NielsDeSimpelaere/Linefollower/readme.md

# LineFollower
<br />
Dit is mijn linefollower
<br />

<br />
Linefollower

<br />
<br />
  
## specifications
<br />
microcontroller: arduino nano
<br />
motors: 50: 1 Micro Metal gearmotor HPCB 6V met Extended Motor Shaft 
<br />
h-bridge: DRV8833
<br />
sensors: QTR-8A
<br />
batteries:  2x LG 18650 Li-ion Batterij - 3400mAh - 10A
<br />
wireless communication: HC-05 Bluetooth module met adapter
<br />
distance sensor - motors: 10,3 cm
<br />
weight: 201 g
<br />
speed: 0,45 m/s
<br />
