NielsDeSimpelaere/Linefollower/gebruiksaanwijzing/readme.md

# Gebruiksaanwijzing

### opladen / vervangen batterijen
Zorg er bij het insteken of het uithalen van de batterijen voor dat de blauwe schakelaar, op de batterijhouder gemonteerd,
uit staat (naar het linker wiel van achteren bekeken toe gericht is).

Om de batterijen op te laden, wordt gebruikt gemaakt van de Xtar MC1 Li-ion Mini Batterijlader. Deze kan 1 batterij opladen op hetzelfde moment
opladen. Zorg ervoor dat de batterij wordt opgeladen tot ongeveer een spanning van 3,5V. Om dit te weten, haal de batterij uit de oplader en meet
de spanning op met een multimeter. Wanneer beide batterijen elk op hun beurt opgeladen zijn tot 3,5V, dan kunnen ze weer in de batterijhouder geplaatst
worden. Zorg ervoor dat de gebruikte batterijen  van het type LG 18650 Li-ion Batterij - 3400mAh - 10A - INR18650 MJ1 zijn.

### draadloze communicatie
#### verbinding maken
Verbinden van de linefollower en de smartphone gebeurt via de app Serial Bluetooth Terminal. Leg bluetooth aan op je smartphone, en ga in de app naar devices. Zorg ervoor dat je verbonden bent met de HC-05. Ga daarna naar de terminal en verbind rechtsboven door ophet symbooltje van de 2 connecties te klikken. Daarna krijg je de melding dat de HC-05 verbonden ("connected") is.

#### commando's
debug: wanneer je dit intypt, zie je al de ingestelde waardes
<br /> 
run: bij het intypenvan run bij stilstand van de linefollower, zal dit de linefollower starten.       Om de linefollower te stoppen moet run opnieuw verzonden worden
<br />
set cycle [µs] : hiermee wordt de waarde van de cycle gedefinieerd .
<br />
set power [0..255] : stel in hoeveel van het maximale vermogen wordt gebruikt.
<br />
set diff [0..1] : zorgt voor de mate van bijsturen bij bochten. Neemt hij de bocht te traag, verhoog dan deze waarde.
<br />
set kp [0..] : zorgt voor bijsturing van de fout met een bepaalde factor.
<br />
set ki [0..] : zorgt voor bijsturing van de fout aan de hand van hoe lang de fout zich voordoet.
<br />
set kd [0..] :  zorgt voor bijsturing van de fout aan de hand van hoe snel de fout verandert.
<br />
calibrate black: gebruik dit commando om de wit waarden te kalibreren wanneer nodig (bij een te grote afwijking ).
<br />
calibrate white: gebruik dit commando om de zwart waarden te kalibreren wanneer nodig (bij een te grote afwijking).
<br />

### kalibratie
Omdat de omstandigheden waarin de linefollower rijdt niet altijd 100% hetzelfde kunnen zijn, moet er bij te sterk verschillende zwart en wit waarden gekalibreerd worden. Hiervoor voeren we eens een kalibratie op een zwarte ondergrond uit en een kalibratie op de witte ondergrond.

Kalibratie voor zwartwaarden:
Zet de linefollower met zijn sensoren op een zwarte ondergrond. Hierop kalibreren we de zwartwaarden. Typ in 'calibrate black' en laat de auto staan. Daarna krijg je de melding dat de kalibratie voor zwart is voltooid.

Kalibratie voor witwaarden:
Zet de linefollower met zijn sensoren op een witte ondergrond. Hierop kalibreren we de witwaarden. Typ in 'calibrate white' en laat de auto staan.
Daarna krijg je de melding dat de kalibratie voor wit is voltooid.

### settings
De robot rijdt stabiel met volgende parameters:  
kp: 1
<br />
diff: 0,10
<br />
ki: 0
<br />
kd: 0,012
<br />
PWR: 65
<br />

### start/stop button
De zwarte knop bevindt zich links op de linefollower dicht bij de Nano microcontroller.
Bij het aanschakelen van de voeding (blauwe schakelaar), zal de microcontroller opstarten. Eenmaal de rode led brandt, wil dit zeggen dat de linefollower volledig is opgestart en deze kan starten met rijden. Om de linefollower te laten starten met de lijn te volgen, druk je op de knop. Wanneer je de lijnvolger weer wilt stoppen, til je de lijnvolger op en druk je weer op deze knop. Doordat deze knop is verbonden met een interrupt, zal de microcontroller het lezen van de loop code onderbreken en meteen het 'run' op nul zetten, dus stoppen.
