NielsDeSimpelaere/Linefollower/code/proof of concepts/sensor/readme.md

# Sensoren proof of concept

minimale hard- en software die aantoont dat de 8 sensoren onafhankelijk van elkaar kunnen uitgelezen worden en dat daarbij een zo groot mogelijk bereik van de AD converter benut wordt
