NielsDeSimpelaere/Linefollower/code/proof of concepts/interrupt/readme.md

# start/stop interrupt proof of concept
minimale hard- en software die de correcte werking van een start/stop drukknop aantoont, gebruik makend van een hardware interrupt

De button is aangesloten op D2, dit is een interrupt pin. De input pullup op de arduino wordt gebruikt. Hiervoor is er dus alleen één button nodig hardwarematig als input van de interrupt.
