NielsDeSimpelaere/Linefollower/technische tekeningen/elektronisch/readme.md

Hier is het elektrische schema te vinden van de volledige schakeling van de linefollower alsook van de aparte POC's.
