NielsDeSimpelaere/Linefollower/code/finaal/readme.md

Dit is de finale code waarmee de linefollower het parcour succesvol kan volgen.
