NielsDeSimpelaere/Linefollower/code/proof of concepts/wireless communication/readme.md

# draadloze communicatie proof of concept
minimale hard- en software waarmee aangetoond wordt dat duplex kan gecommuniceerd worden tussen de microcontroller en een smartphone, gebruik makend van Serial Bluetooth Terminal.
<br />

### gebruiksaanwijzing
Om verbinding te maken, moet je de code ingeven. Dez is ofwel 0000 of 1234. Wanneer dit is gelukt, voeg dan HC-05 toe in Serial Bluetooth Terminal
en verbind hiermee met je gsm.
