NielsDeSimpelaere/Linefollower/code/proof of concepts/hbridge/Afmeting motor houder.jpg

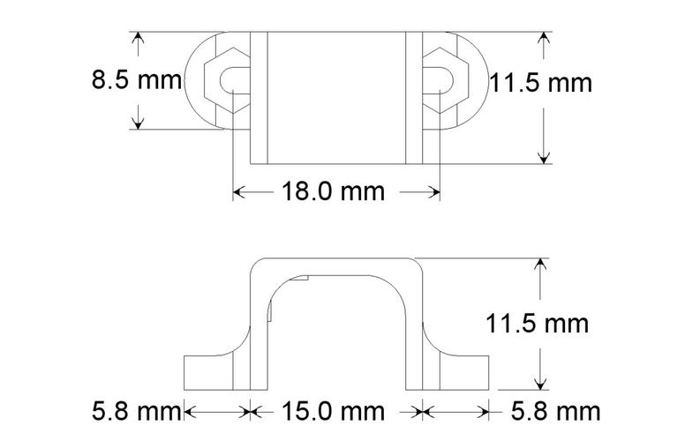
code/proof of concepts/hbridge/Afmeting motor houder.jpg
