NielsDeSimpelaere/Linefollower/bill of materials/readme.md

## bill of materials
<br />

|volgnummer|naam |omschrijving |nieuw/recup|kostprijs/stuk|aantal|subtotaal|
|---|---|---|---|---|---|---|
| 1|Microcontroller |Microcontroller arduino nano | nieuw |€ 24,00 |  1 |€ 24,00  |
| 2|DRV8833 |DRV8833 Bipolaire Stappenmotor- en DC-Motoraansturing | nieuw |€ 3,00 |  1 |€ 3,00 |
| 3|HC-05 |HC-05 Bluetooth module met adapter | nieuw |€ 6,50 |  1 |€ 6,50 |
| 4|QTA-8A |Reflectance Sensor array | nieuw |€ 12,30 |  1 |€ 12,30  |
| 5|Motor |50:1 Micro Metal gearmotor HPB 6V met Extended Motor Shaft| nieuw |€ 21,60 |  2 |€ 43,20  |
| 6|Motorbevestiging|2x Pololu bevestiging motor plus bout en moer | nieuw |€ 3,55 |  1 |€ 3,55 |
| 7|Batterij |LG 18650 Li-ion Batterij - 3400mAh - 10A | nieuw |€ 6,00 |  2 |€ 12,00  |
| 8|Batterijhouder  |2x 18650 Batterijhouder | nieuw |€ 1,50 |  1 |€ 1,50 |
| 9|Batterijlader |Xtar MC1 Li-ion Mini Batterijlader | nieuw |€ 4,50 |  1 |€ 4,50 |
| 10|Wielen |Pololu Wiel 40x7mm-2 stuks | nieuw |€ 4,90 |  1 |€ 4,90 |
| 11|HoofdSchakelaar |Toggle Switch Enkelpolig ON-ON 6A - 125V/ 3A - 250V | nieuw |€ 1,50 |  1 |€ 1,50 |
| 12|Schakelaar HC05 |Schuifschakelaar enkelpolig ON-ON SPDT 0,5A 12V | nieuw |€ 1,96 |  1 |€ 1,96 |
| 13|Drukknop |Drukknop | recup |€ 0 |  1 |€ 0 |
| 14|Led blauw |Blauwe led | recup |€ 0 |  1 |€ 0 |
| 15|Led rood |Rode led | recup |€ 0 |  1 |€ 0 |
| 16|Weerstand 220 Ω |Weerstand 220 Ω | recup |€ 0 |  2 |€ 0 |
| 17|Weerstand 1 KΩ  |Weerstand 1 KΩ | recup |€ 0 |  3 |€ 0 |  
| 18|Printplaat |Printplaat met Cu-laag 50mm x 100mm | nieuw |€ 2,00 |  2 |€ 4,00 |
| 19|bout en moer |Bout M4*20 en moer M4 voor montage | recup |€ 0 |  5 |€ 0 |
| 20|kabels |kabels | recup |€ 0 |  30  |€ 0 |
