NielsDeSimpelaere/Linefollower/technische tekeningen/elektronisch/Elektrisch schema POC StartStop interrupt.pdf

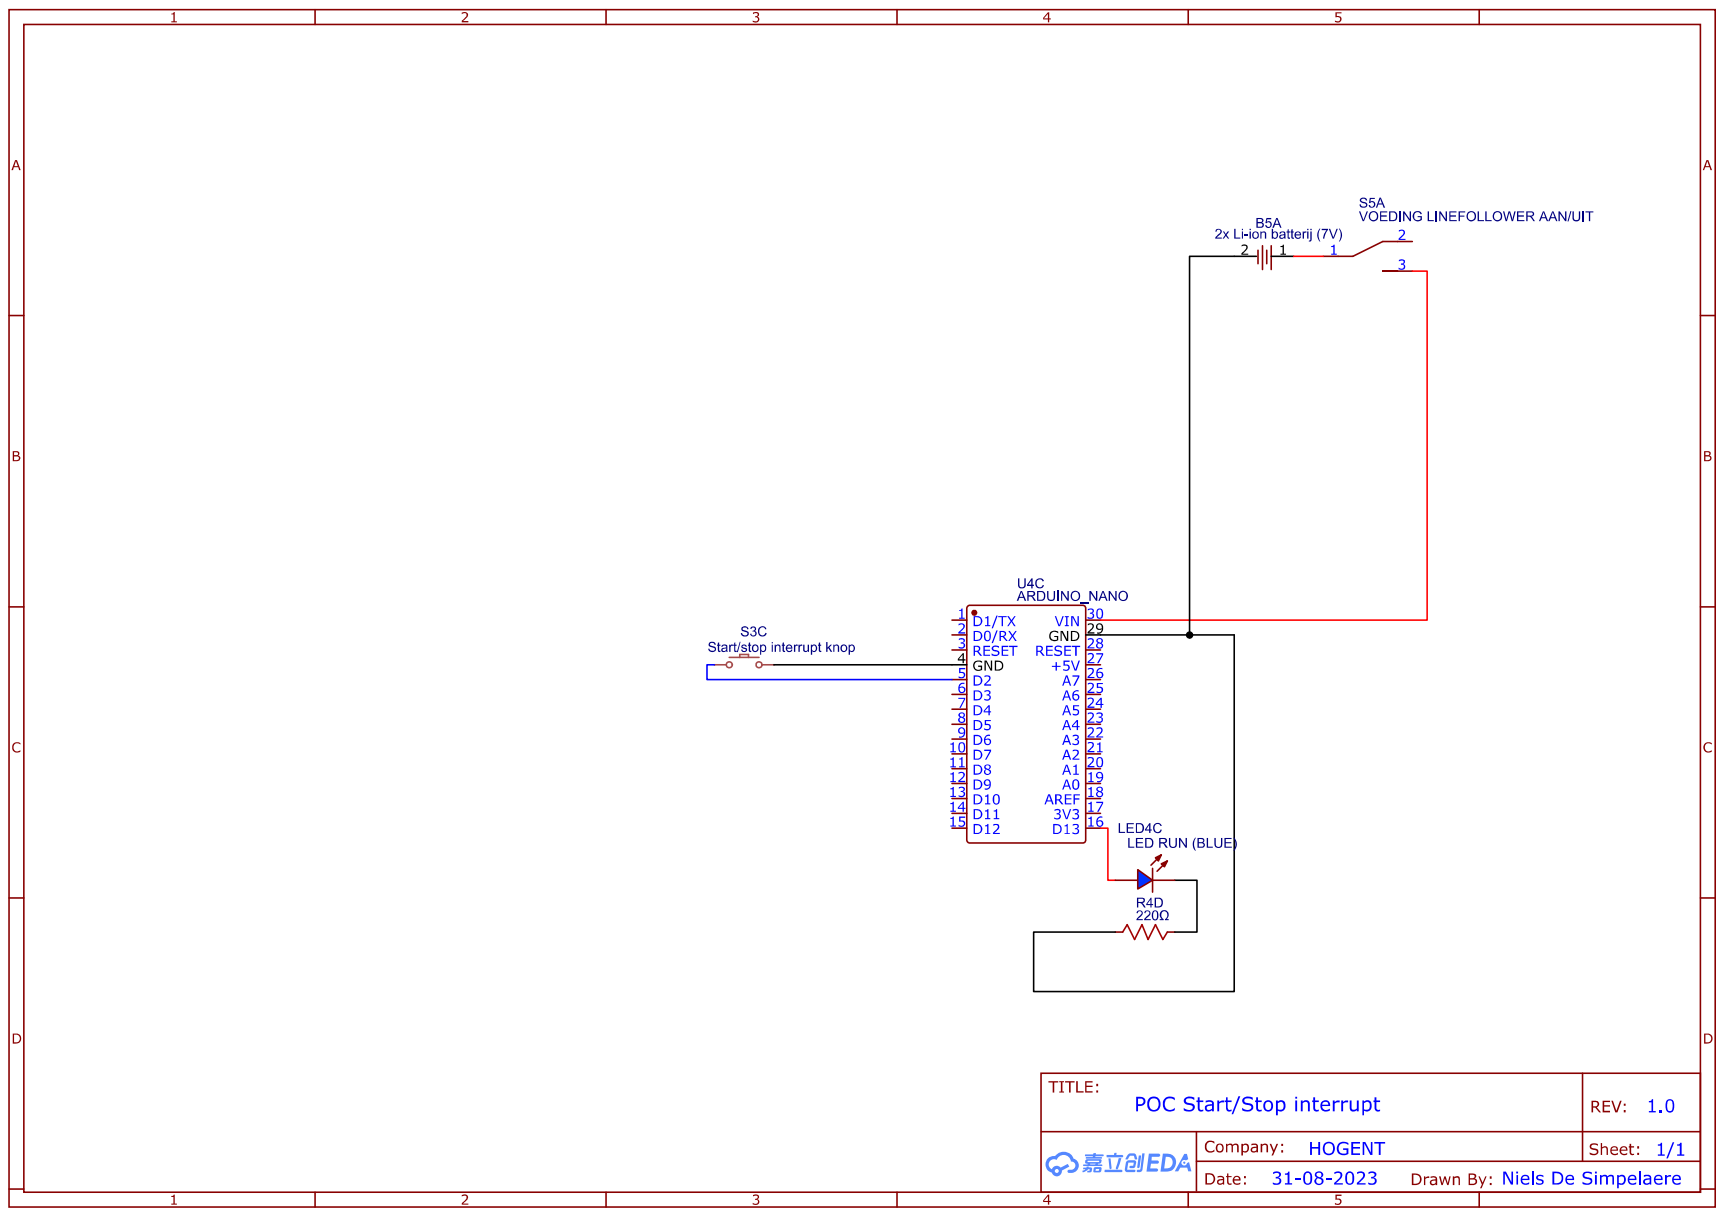
[picture p2: page 1]
