NielsDeSimpelaere/Linefollower/technische tekeningen/elektronisch/Elektrisch schema linefollower.pdf

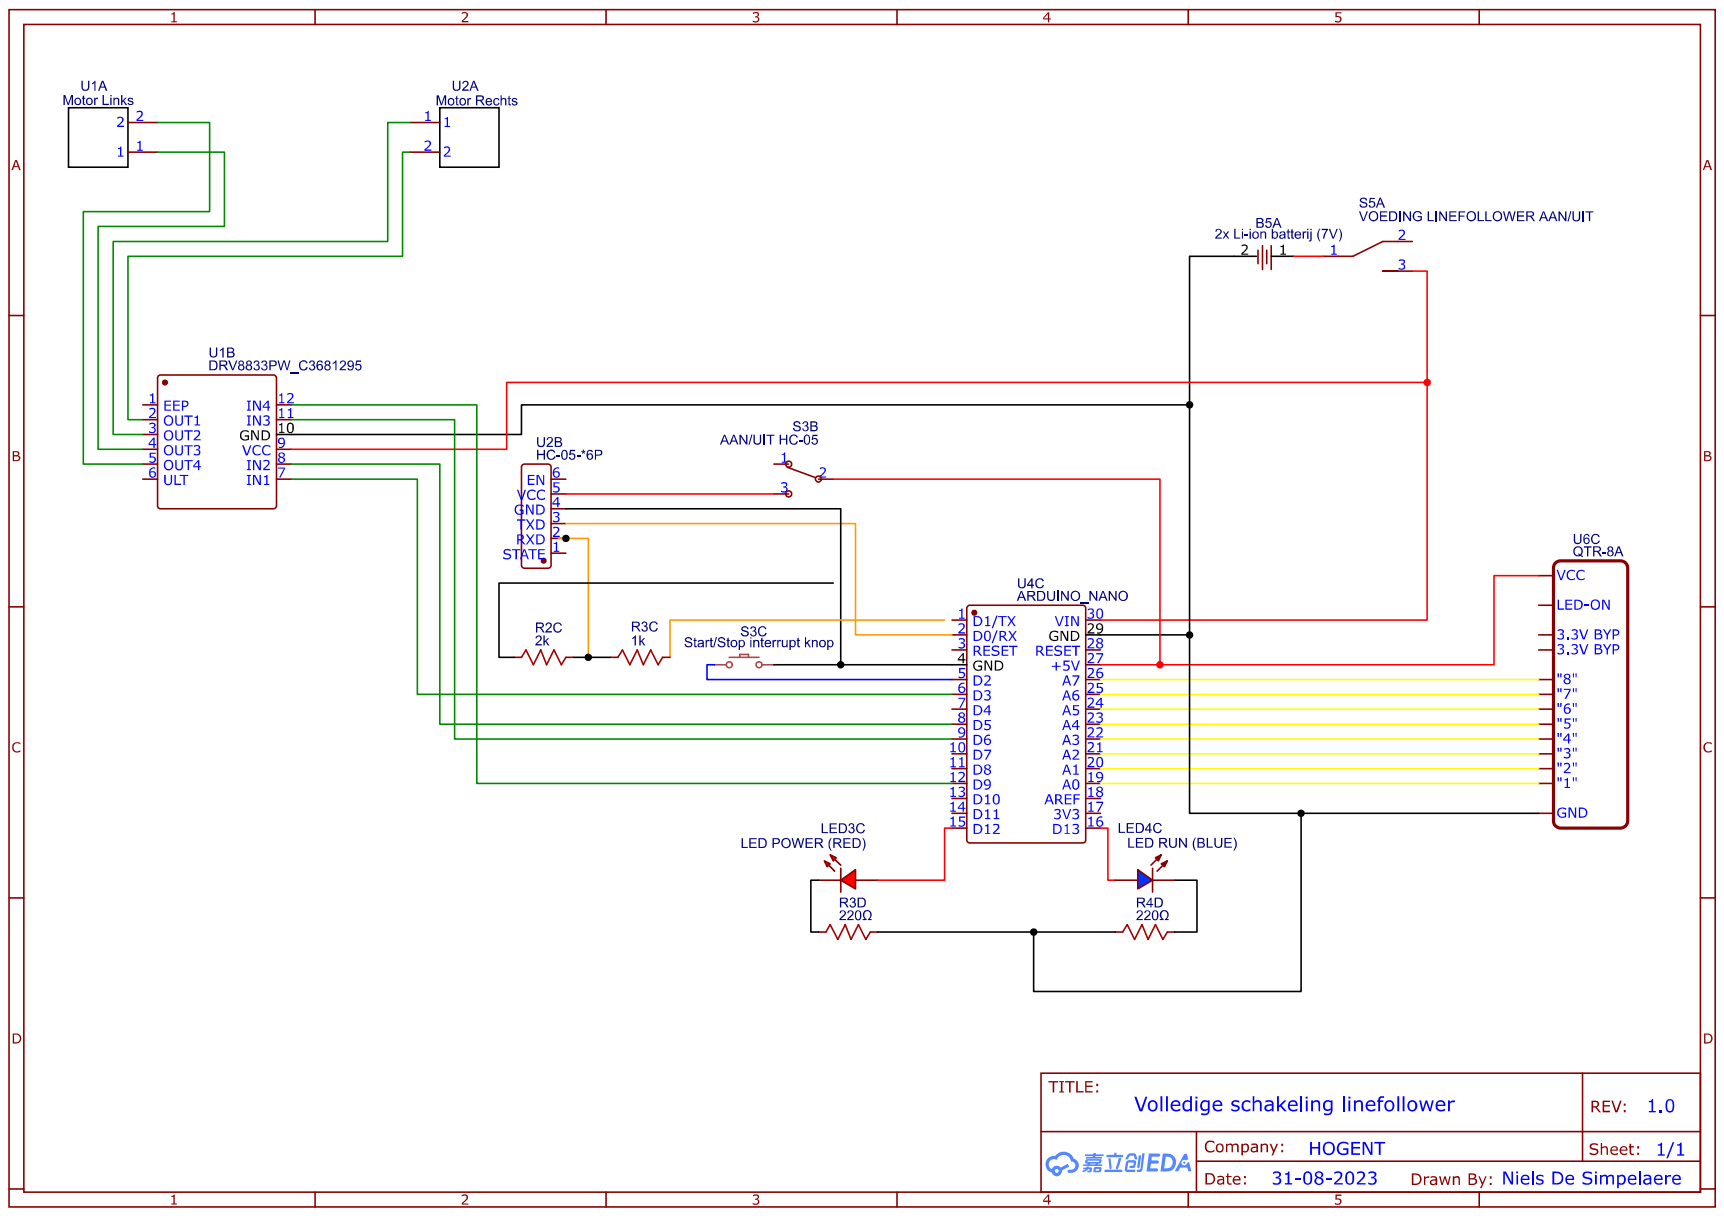
[picture p3: page 1]
