NielsDeSimpelaere/Linefollower/technische tekeningen/elektronisch/Elektrisch schema POC HC05 bluetooth.pdf

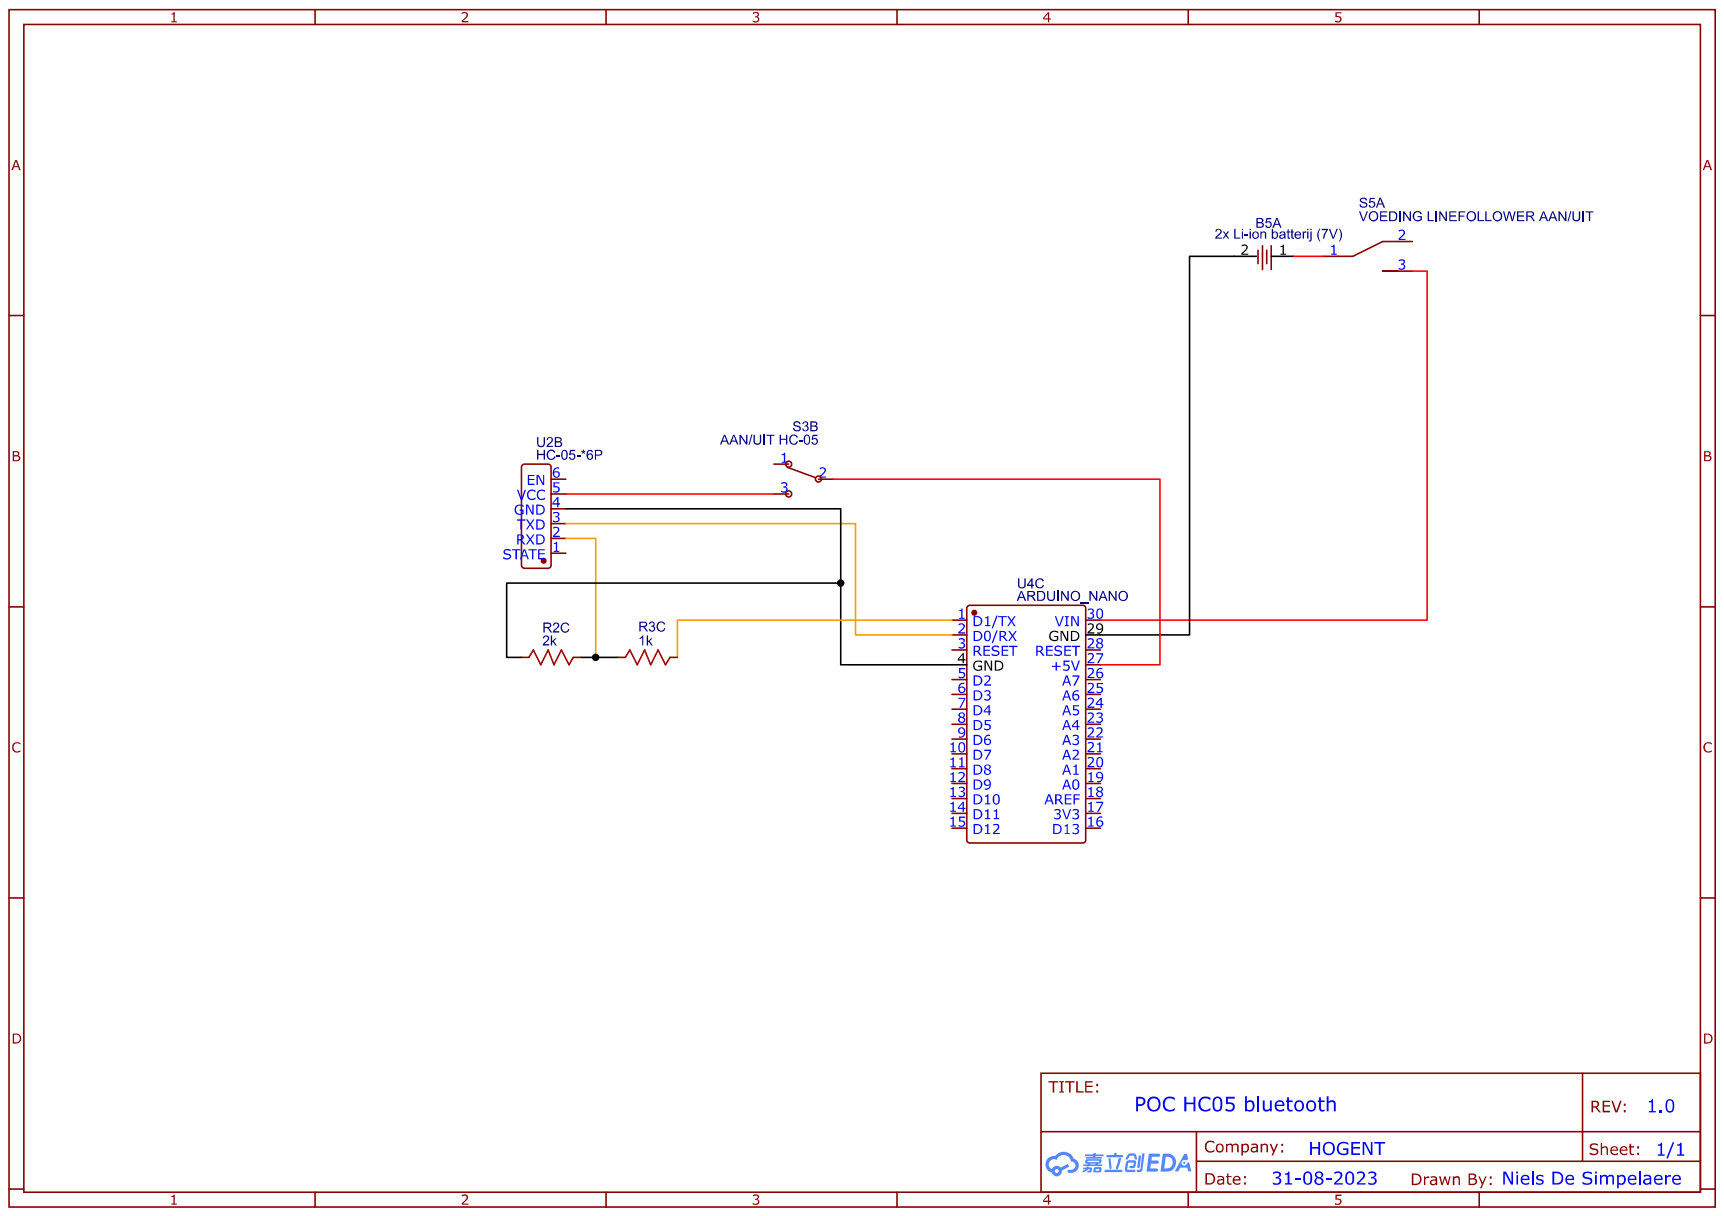
[picture p4: page 1]
