NielsDeSimpelaere/Linefollower/technische tekeningen/elektronisch/Elektrisch schema POC DRV8833 en motoren.pdf

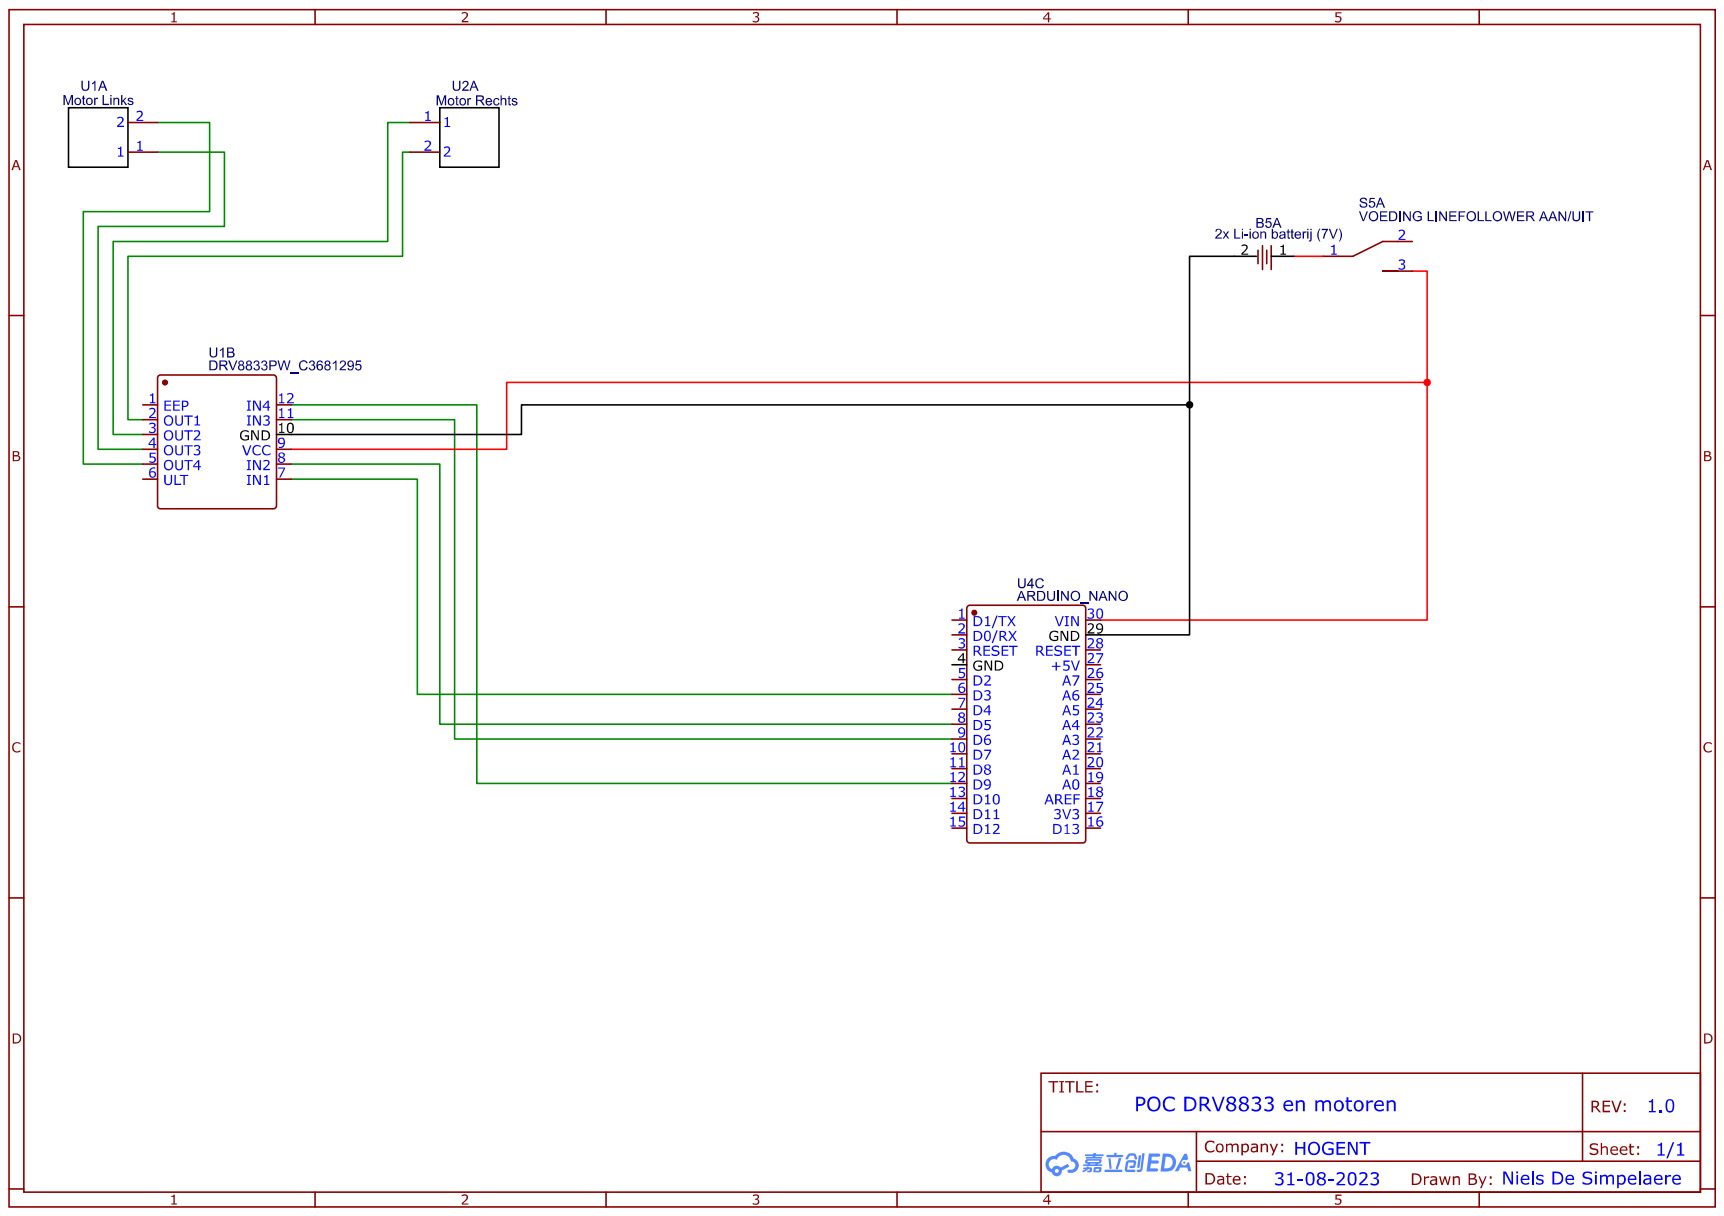
[picture p5: page 1]
