NielsDeSimpelaere/Linefollower/technische tekeningen/elektronisch/Elektrisch schema POC QTR-8A sensor.pdf

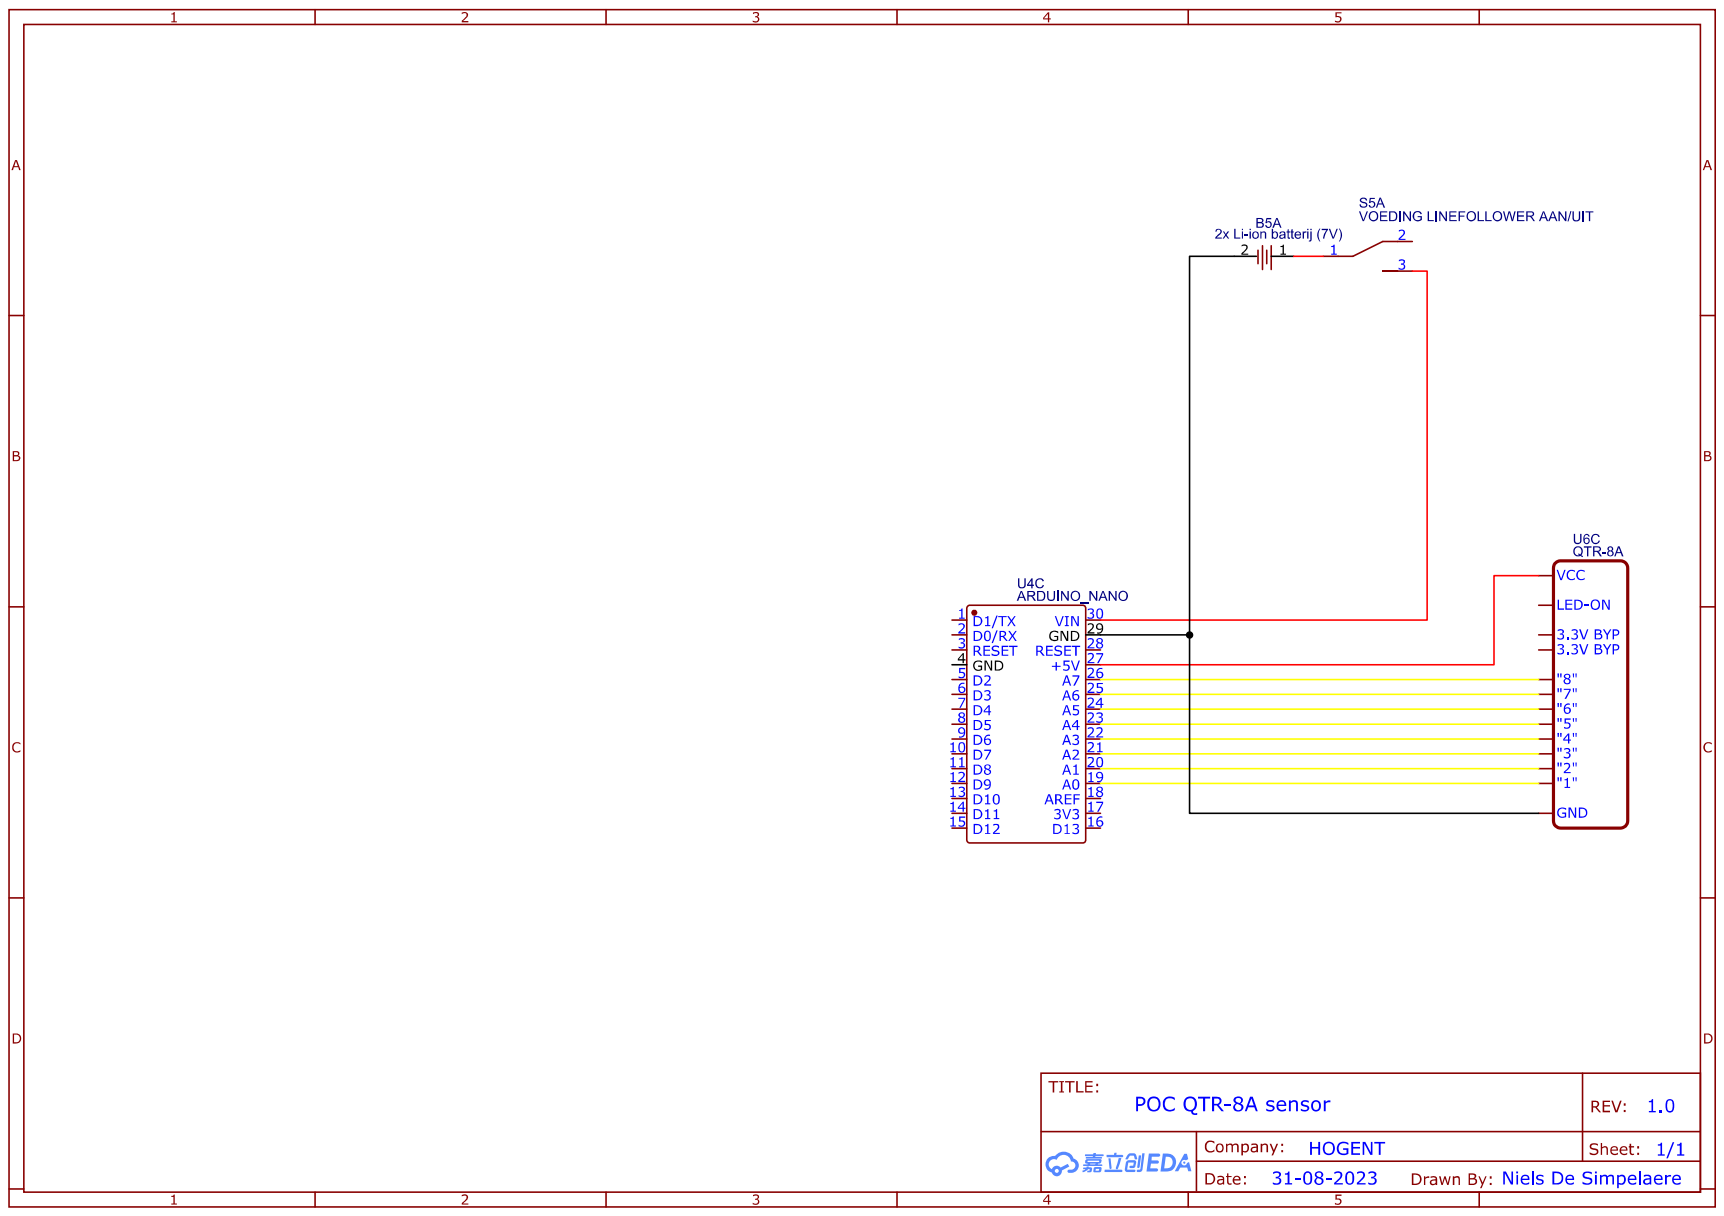
[picture p6: page 1]
